MTwarog04/realtime_color_tracking_systemverilog/fpga/rtl/top_basys3.sv

/* Autor: Mikołaj Twaróg */
/**
 * San Jose State University
 * EE178 Lab #4
 * Author: prof. Eric Crabilla
 *
 * Modified by:
 * 2025  AGH University of Science and Technology
 * MTM UEC2
 * Piotr Kaczmarczyk
 *
 * Description:
 * Top level synthesizable module including the project top and all the FPGA-referred modules.
 */

module top_basys3 (
        input  wire clk,
        input  wire btnC,
        output wire [15:0] led,
        input  wire [15:0] sw,
        output wire servo_pan_pwm,
        output wire servo_tilt_pwm,
        output wire ov7670_sioc,
        inout  wire ov7670_siod,
        input  wire ov7670_vsync,
        input  wire ov7670_href,
        input  wire ov7670_pclk,
        output wire ov7670_xclk,
        input  wire [7:0] ov7670_data,
        output wire [3:0] vgaRed,
        output wire [3:0] vgaGreen,
        output wire [3:0] vgaBlue,
        output wire Hsync,
        output wire Vsync
    );

    timeunit 1ns;
    timeprecision 1ps;

    wire clk_in, clk_fb, clk_ss, clk_out;
    wire locked;
    wire pclk;
    wire pclk_mirror;

    (* KEEP = "TRUE" *)
    (* ASYNC_REG = "TRUE" *)
    logic [7:0] safe_start;

    IBUF clk_ibuf (
        .I(clk),
        .O(clk_in)
    );

    MMCME2_BASE #(
        .CLKIN1_PERIOD(10.000),
        .CLKFBOUT_MULT_F(10.000),
        .CLKOUT0_DIVIDE_F(25.000)
    ) clk_in_mmcme2 (
        .CLKIN1(clk_in),
        .CLKOUT0(clk_out),
        .CLKOUT0B(),
        .CLKOUT1(),
        .CLKOUT1B(),
        .CLKOUT2(),
        .CLKOUT2B(),
        .CLKOUT3(),
        .CLKOUT3B(),
        .CLKOUT4(),
        .CLKOUT5(),
        .CLKOUT6(),
        .CLKFBOUT(clk_fb),
        .CLKFBOUTB(),
        .CLKFBIN(clk_fb),
        .LOCKED(locked),
        .PWRDWN(1'b0),
        .RST(1'b0)
    );

    BUFH clk_out_bufh (
        .I(clk_out),
        .O(clk_ss)
    );

    always_ff @(posedge clk_ss or negedge locked) begin
        if (!locked) begin
            safe_start <= '0;
        end else begin
            safe_start <= {safe_start[6:0], 1'b1};
        end
    end

    BUFGCE #(
        .SIM_DEVICE("7SERIES")
    ) clk_out_bufgce (
        .I(clk_out),
        .CE(safe_start[7]),
        .O(pclk)
    );

    top u_top (
        .clk(pclk),
        .rst(btnC),
        .led(led),
        .sw(sw),
        .servo_pan_pwm(servo_pan_pwm),
        .servo_tilt_pwm(servo_tilt_pwm),
        .ov7670_sioc(ov7670_sioc),
        .ov7670_siod(ov7670_siod),
        .ov7670_vsync(ov7670_vsync),
        .ov7670_href(ov7670_href),
        .ov7670_pclk(ov7670_pclk),
        .ov7670_xclk(ov7670_xclk),
        .ov7670_data(ov7670_data),
        .vs(Vsync),
        .hs(Hsync),
        .r(vgaRed),
        .g(vgaGreen),
        .b(vgaBlue)
    );

endmodule
