MTwarog04/realtime_color_tracking_systemverilog/rtl/display/vga_frame_renderer.sv

/* Autor: Mikołaj Twaróg */
module vga_frame_renderer
    import vga_pkg::*;
#(
        parameter int FRAME_WIDTH = 320,
        parameter int FRAME_HEIGHT = 240,
        parameter int SCALE = 2,
        parameter int X_OFFSET = 272,
        parameter int Y_OFFSET = 64
    ) (
        input  logic clk,
        input  logic rst_n,
        input  logic frame_valid,
        input  logic diag_enable,
        input  logic [1:0] diag_channel,
        input  logic track_valid,
        input  logic [8:0] target_x,
        input  logic [7:0] target_y,

        input  logic [10:0] vcount_in,
        input  logic        vsync_in,
        input  logic        vblnk_in,
        input  logic [10:0] hcount_in,
        input  logic        hsync_in,
        input  logic        hblnk_in,

        output logic [$clog2(FRAME_WIDTH * FRAME_HEIGHT)-1:0] frame_rd_addr,
        input  logic [3:0] frame_rd_data,

        output logic [10:0] vcount_out,
        output logic        vsync_out,
        output logic        vblnk_out,
        output logic [10:0] hcount_out,
        output logic        hsync_out,
        output logic        hblnk_out,
        output logic [11:0] rgb_out
    );

    timeunit 1ns;
    timeprecision 1ps;

    localparam int ROT_WIDTH = FRAME_HEIGHT;
    localparam int ROT_HEIGHT = FRAME_WIDTH;
    localparam int DISPLAY_WIDTH = ROT_WIDTH * SCALE;
    localparam int DISPLAY_HEIGHT = ROT_HEIGHT * SCALE;
    localparam int DISPLAY_X_OFFSET = X_OFFSET;
    localparam int DISPLAY_Y_OFFSET = Y_OFFSET;
    localparam int BORDER_X0 = (DISPLAY_X_OFFSET >= 2) ? (DISPLAY_X_OFFSET - 2) : 0;
    localparam int BORDER_Y0 = (DISPLAY_Y_OFFSET >= 2) ? (DISPLAY_Y_OFFSET - 2) : 0;
    localparam int BORDER_X1 = DISPLAY_X_OFFSET + DISPLAY_WIDTH + 2;
    localparam int BORDER_Y1 = DISPLAY_Y_OFFSET + DISPLAY_HEIGHT + 2;

    logic visible_now;
    logic border_now;
    logic banner_now;
    logic track_indicator_now;
    logic crosshair_now;
    logic [$clog2(FRAME_WIDTH * FRAME_HEIGHT)-1:0] frame_rd_addr_nxt;
    logic [10:0] image_x;
    logic [10:0] image_y;
    logic [10:0] rot_x;
    logic [10:0] rot_y;
    logic [10:0] src_x;
    logic [10:0] src_y;
    logic [10:0] src_x_pipe;
    logic [10:0] src_y_pipe;

    logic [2:0] visible_pipe;
    logic [2:0] border_pipe;
    logic [2:0] banner_pipe;
    logic [2:0] track_indicator_pipe;
    logic [2:0] frame_valid_pipe;
    logic [2:0] track_valid_pipe;
    logic [2:0] diag_enable_pipe;
    logic [1:0] diag_channel_pipe [0:2];
    logic [2:0] crosshair_pipe;

    function automatic logic [4:0] font_row(input logic [7:0] ch, input integer row);
        begin
            case (ch)
                "B": case (row)
                    0: font_row = 5'b11110;
                    1: font_row = 5'b10001;
                    2: font_row = 5'b11110;
                    3: font_row = 5'b10001;
                    4: font_row = 5'b10001;
                    5: font_row = 5'b10001;
                    6: font_row = 5'b11110;
                    default: font_row = 5'b00000;
                endcase
                "E": case (row)
                    0: font_row = 5'b11111;
                    1: font_row = 5'b10000;
                    2: font_row = 5'b11110;
                    3: font_row = 5'b10000;
                    4: font_row = 5'b10000;
                    5: font_row = 5'b10000;
                    6: font_row = 5'b11111;
                    default: font_row = 5'b00000;
                endcase
                "2": case (row)
                    0: font_row = 5'b01110;
                    1: font_row = 5'b10001;
                    2: font_row = 5'b00001;
                    3: font_row = 5'b00010;
                    4: font_row = 5'b00100;
                    5: font_row = 5'b01000;
                    6: font_row = 5'b11111;
                    default: font_row = 5'b00000;
                endcase
                default: font_row = 5'b00000;
            endcase
        end
    endfunction

    function automatic logic char_pixel(
        input integer pixel_x,
        input integer pixel_y,
        input integer origin_x,
        input integer origin_y,
        input integer scale,
        input logic [7:0] ch
    );
        integer local_x;
        integer local_y;
        logic [4:0] row_bits;
        begin
            char_pixel = 1'b0;
            if ((pixel_x >= origin_x) && (pixel_x < (origin_x + (5 * scale))) &&
                (pixel_y >= origin_y) && (pixel_y < (origin_y + (7 * scale)))) begin
                local_x = (pixel_x - origin_x) / scale;
                local_y = (pixel_y - origin_y) / scale;
                row_bits = font_row(ch, local_y);
                char_pixel = row_bits[4 - local_x];
            end
        end
    endfunction

    logic [10:0] vcount_pipe [0:2];
    logic [10:0] hcount_pipe [0:2];
    logic [2:0] vsync_pipe;
    logic [2:0] vblnk_pipe;
    logic [2:0] hsync_pipe;
    logic [2:0] hblnk_pipe;

    int diff_x, diff_y;

    always_comb begin
        visible_now = (!vblnk_in && !hblnk_in) &&
            (hcount_in >= DISPLAY_X_OFFSET) && (hcount_in < (DISPLAY_X_OFFSET + DISPLAY_WIDTH)) &&
            (vcount_in >= DISPLAY_Y_OFFSET) && (vcount_in < (DISPLAY_Y_OFFSET + DISPLAY_HEIGHT));

        border_now = (!vblnk_in && !hblnk_in) &&
            (hcount_in >= BORDER_X0) && (hcount_in < BORDER_X1) &&
            (vcount_in >= BORDER_Y0) && (vcount_in < BORDER_Y1) &&
            !visible_now;

        banner_now = (!vblnk_in && !hblnk_in) &&
            (hcount_in >= 70) && (hcount_in < 350) &&
            (vcount_in >= 12) && (vcount_in < 56);

        track_indicator_now = (!vblnk_in && !hblnk_in) &&
            (hcount_in >= 84) && (hcount_in < 112) &&
            (vcount_in >= 20) && (vcount_in < 48);

        if (visible_now) begin
            image_x = hcount_in - DISPLAY_X_OFFSET;
            image_y = vcount_in - DISPLAY_Y_OFFSET;
            rot_x = image_x / SCALE;
            rot_y = image_y / SCALE;
            src_x = rot_y;
            src_y = FRAME_HEIGHT - 1 - rot_x;
            diff_x = $signed({1'b0, src_x}) - $signed({3'b0, target_x});
            diff_y = $signed({1'b0, src_y}) - $signed({4'b0, target_y});
            crosshair_now = 1'b0;
            if ((diff_y == 0) && (diff_x > -15) && (diff_x < 15)) begin
                crosshair_now = 1'b1;
            end
            if ((diff_x == 0) && (diff_y > -15) && (diff_y < 15)) begin
                crosshair_now = 1'b1;
            end
            if ((diff_x > -3) && (diff_x < 3) &&
                (diff_y > -3) && (diff_y < 3)) begin
                crosshair_now = 1'b0; /* Pusty srodek celownika */
            end
        end else begin
            image_x = '0;
            image_y = '0;
            rot_x = '0;
            rot_y = '0;
            src_x = '0;
            src_y = '0;
            crosshair_now = 1'b0;
        end
    end

    assign frame_rd_addr_nxt = (src_y_pipe * FRAME_WIDTH) + src_x_pipe;

    always_ff @(posedge clk or negedge rst_n) begin
        if (!rst_n) begin
            frame_rd_addr <= '0;
            src_x_pipe <= '0;
            src_y_pipe <= '0;
            visible_pipe <= '0;
            border_pipe <= '0;
            banner_pipe <= '0;
            track_indicator_pipe <= '0;
            frame_valid_pipe <= '0;
            track_valid_pipe <= '0;
            crosshair_pipe <= '0;
            diag_enable_pipe <= '0;
            diag_channel_pipe[0] <= '0;
            diag_channel_pipe[1] <= '0;
            diag_channel_pipe[2] <= '0;
            vcount_pipe[0] <= '0;
            vcount_pipe[1] <= '0;
            vcount_pipe[2] <= '0;
            hcount_pipe[0] <= '0;
            hcount_pipe[1] <= '0;
            hcount_pipe[2] <= '0;
            vsync_pipe <= '0;
            vblnk_pipe <= '0;
            hsync_pipe <= '0;
            hblnk_pipe <= '0;
            vcount_out <= '0;
            hcount_out <= '0;
            vsync_out <= 1'b0;
            vblnk_out <= 1'b0;
            hsync_out <= 1'b0;
            hblnk_out <= 1'b0;
            rgb_out <= 12'h0_0_0;
        end else begin
            frame_rd_addr <= frame_rd_addr_nxt;
            src_x_pipe <= src_x;
            src_y_pipe <= src_y;

            visible_pipe <= {visible_pipe[1:0], visible_now};
            border_pipe <= {border_pipe[1:0], border_now};
            banner_pipe <= {banner_pipe[1:0], banner_now};
            track_indicator_pipe <= {track_indicator_pipe[1:0], track_indicator_now};
            frame_valid_pipe <= {frame_valid_pipe[1:0], frame_valid};
            track_valid_pipe <= {track_valid_pipe[1:0], track_valid};
            crosshair_pipe <= {crosshair_pipe[1:0], crosshair_now};
            diag_enable_pipe <= {diag_enable_pipe[1:0], diag_enable};
            diag_channel_pipe[0] <= diag_channel;
            diag_channel_pipe[1] <= diag_channel_pipe[0];
            diag_channel_pipe[2] <= diag_channel_pipe[1];

            vcount_pipe[0] <= vcount_in;
            vcount_pipe[1] <= vcount_pipe[0];
            vcount_pipe[2] <= vcount_pipe[1];
            hcount_pipe[0] <= hcount_in;
            hcount_pipe[1] <= hcount_pipe[0];
            hcount_pipe[2] <= hcount_pipe[1];
            vsync_pipe <= {vsync_pipe[1:0], vsync_in};
            vblnk_pipe <= {vblnk_pipe[1:0], vblnk_in};
            hsync_pipe <= {hsync_pipe[1:0], hsync_in};
            hblnk_pipe <= {hblnk_pipe[1:0], hblnk_in};

            vcount_out <= vcount_pipe[2];
            hcount_out <= hcount_pipe[2];
            vsync_out <= vsync_pipe[2];
            vblnk_out <= vblnk_pipe[2];
            hsync_out <= hsync_pipe[2];
            hblnk_out <= hblnk_pipe[2];

            if (vblnk_pipe[2] || hblnk_pipe[2]) begin
                rgb_out <= 12'h0_0_0;
            end else if (visible_pipe[2] && frame_valid_pipe[2]) begin
                if (diag_enable_pipe[2]) begin
                    case (diag_channel_pipe[2])
                        2'b01: rgb_out <= {4'h0, frame_rd_data, frame_rd_data};
                        2'b10: rgb_out <= {frame_rd_data, 4'h0, frame_rd_data};
                        2'b11: rgb_out <= {frame_rd_data, frame_rd_data, 4'h0};
                        default: rgb_out <= {frame_rd_data, frame_rd_data, frame_rd_data};
                    endcase
                end else if (crosshair_pipe[2]) begin
                    rgb_out <= 12'hf_0_0;
                end else begin
                    rgb_out <= {frame_rd_data, frame_rd_data, frame_rd_data};
                end
            end else if (border_pipe[2]) begin
                rgb_out <= frame_valid_pipe[2] ? 12'h0_d_7 : 12'hd_8_0;
            end else begin
                rgb_out <= frame_valid_pipe[2] ? 12'h0_1_1 : 12'h1_0_0;
            end

            if (banner_pipe[2] && !diag_enable_pipe[2]) begin
                rgb_out <= 12'h0_0_3;
            end

            if (track_indicator_pipe[2] && !diag_enable_pipe[2]) begin
                rgb_out <= track_valid_pipe[2] ? 12'h0_f_0 : 12'h8_0_0;
            end
        end
    end

endmodule
