MTwarog04/realtime_color_tracking_systemverilog/(commit log)

2026-05-30 Get OV7670 camera working with YUV422 and VGA preview
    I2C setup, capture module and 320x240 display with switchable Y/Cb/Cr view.
2026-05-30 WiP:Add blob centroid, track lock and LED size bar
2026-05-30 Update classifier and VGA integration (WIP tracking) Tracking works but still needs tuning for example: crosshair centering, crosshair speed, occasional false detections, minor fixes
    [top_vga.sv, ycbcr_classifier.sv]
2026-05-31 Add PWM and servo control (WIP)
2026-09-01 kalibracja servo
